KaushikApp123/balance-bot/hardware/bom.csv

Ref | Qty | Part | Package | Value / Notes | Example source
U1 | 1 | WeAct BlackPill STM32F411CEU6 | 2x20 0.1in socket | Cortex-M4F @ 100 MHz, 512 KB flash, 128 KB RAM, 25 MHz HSE | AliExpress / WeAct store
U2 | 1 | MPU-6050 module (GY-521) | 1x8 0.1in header | 3-axis accel + gyro, I2C 0x68, INT on PB5 | AliExpress / Amazon
U3 | 1 | ESP32-C3-MINI-1-N4 | module | BLE 5 bridge (Nordic UART Service) | DigiKey 1965-ESP32-C3-MINI-1-N4CT-ND
U4,U5 | 2 | TI DRV8874PWPR | HTSSOP-16 | H-bridge, 37 V, 6 A peak, PH/EN mode, IPROPI current sense | DigiKey 296-DRV8874PWPRCT-ND
U6 | 1 | TI TPS563201DDCR | SOT-23-6 | Buck 4.5-17 V in, 5 V / 3 A out | DigiKey 296-TPS563201DDCRCT-ND
U7 | 1 | Diodes AP2112K-3.3TRG1 | SOT-23-5 | 3.3 V 600 mA LDO for the ESP32-C3 | DigiKey AP2112K-3.3TRG1DICT-ND
Q1 | 1 | AO3401A P-MOSFET | SOT-23 | Reverse battery protection | LCSC C15127
F1 | 1 | PTC fuse 5 A hold | 1812 | Battery input | Littelfuse 1812L500/16MR
J1 | 1 | XT30 male | THT | Battery input (3S LiPo) | Amass XT30PW-M
J2,J3 | 2 | JST-XH 6-pin | THT | Motor + encoder (M+, M-, 3V3, GND, A, B) | JST B6B-XH-A
J4 | 1 | 2x5 1.27 mm SWD header | SMD | ST-Link V2/V3 (SWDIO PA13, SWCLK PA14, NRST) | Samtec FTSH-105-01
J5 | 1 | 1x3 0.1in header | THT | Debug UART (PA2 TX / PA3 RX / GND)
SW1 | 1 | Slide switch | THT | Main power
R1 | 1 | 100 k 1% | 0603 | Battery divider top
R2 | 1 | 22 k 1% | 0603 | Battery divider bottom (11.0 V -> 1.98 V)
C1 | 1 | 100 nF | 0603 | ADC filter on PA4
R3,R4 | 2 | 2.2 k | 0603 | I2C pull-ups to 3V3
R5,R6,R7,R8 | 4 | 10 k | 0603 | Encoder A/B pull-ups to 3V3
R9,R10 | 2 | 1.5 k 1% | 0603 | DRV8874 IPROPI sense (to PA0/PA1 for a future current loop)
R11 | 1 | 10 k | 0603 | nFAULT pull-up (wired-OR of both drivers)
C2 | 1 | 220 uF 25 V electrolytic | 8x10 mm | VM bulk cap near the drivers
C3,C4 | 2 | 10 uF 25 V X7R | 1206 | VM local cap per driver
C5,C6 | 2 | 100 nF 50 V X7R | 0603 | VM high-frequency cap per driver
C7 | 1 | 22 uF 25 V X5R | 1206 | Buck input (sees up to 12.6 V)
C8 | 1 | 22 uF 10 V X5R | 0805 | Buck output
L1 | 1 | 3.3 uH 4 A | 4x4 mm | Buck inductor | Wurth 74438357033
C9,C10 | 2 | 10 uF X5R | 0805 | LDO in/out
C11 | 1 | 100 nF | 0603 | IMU local decoupling next to the header
M1,M2 | 2 | JGB37-520 12 V 330 rpm with Hall encoder |  | 30:1 gear, 11 PPR -> 1320 counts/rev at 4x | AliExpress
W1,W2 | 2 | 65 mm rubber wheel (6 mm D shaft)
B1 | 1 | 3S LiPo 1300 mAh 11.1 V |  | XT30 lead
